AlexanderBarsc/Diplomka/Diplomka/Images/FinalAssembly.png

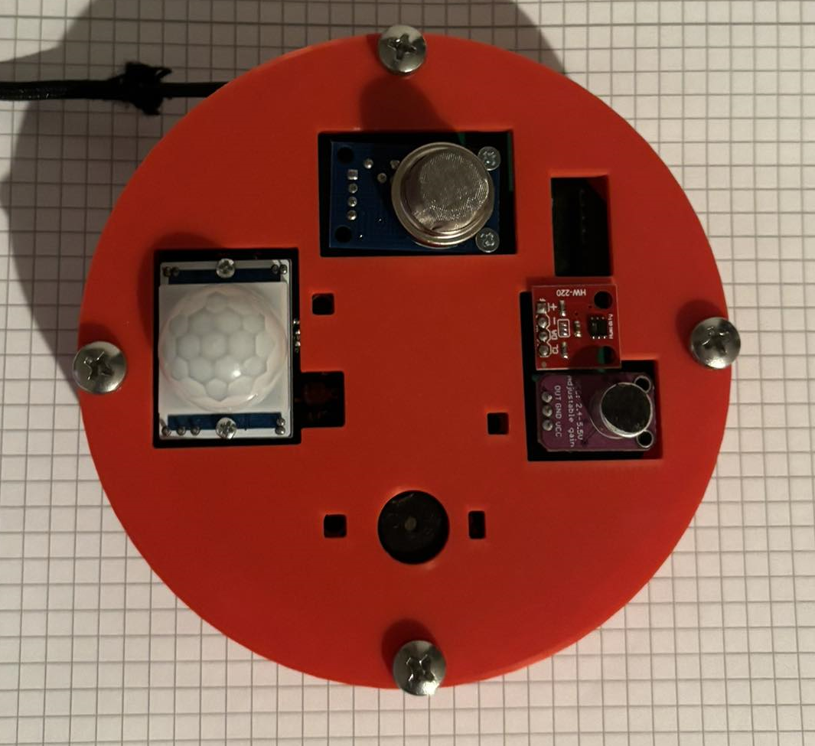
Diplomka/Images/FinalAssembly.png
