AlexanderBarsc/Diplomka/Diplomka/Images/439592605_353315911055319_5232391731507984202_n.jpg

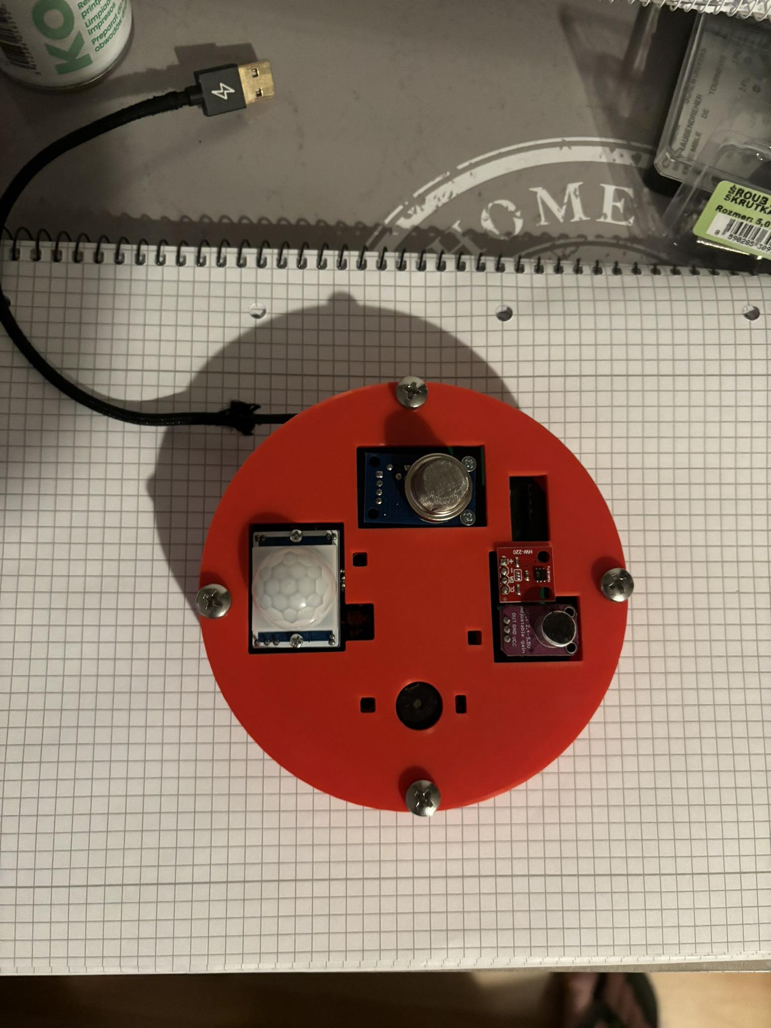
Diplomka/Images/439592605_353315911055319_5232391731507984202_n.jpg
