AlexanderBarsc/Diplomka/README.md

# Diplomka
Všechno potřebné pro diplomku
Tady odkaz na samotnou práci: https://www.overleaf.com/5378626868ssqpxgxytjcf
