AlexanderBarsc/Diplomka/Diplomka/Adafruit-MAX4466-Electret-Mic-Amplifier-PCBs-master/Adafruit-MAX4466-Electret-Mic-Amplifier-PCBs-master/MAX.png

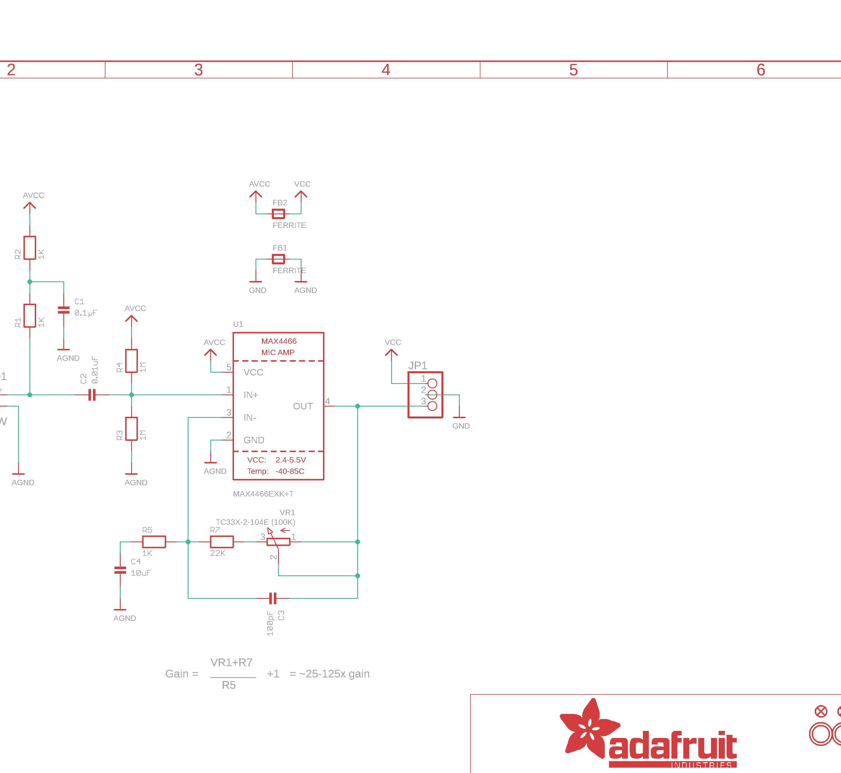
Diplomka/Adafruit-MAX4466-Electret-Mic-Amplifier-PCBs-master/Adafruit-MAX4466-Electret-Mic-Amplifier-PCBs-master/MAX.png
