AlexanderBarsc/Diplomka/Diplomka/Images/Diplomka.png

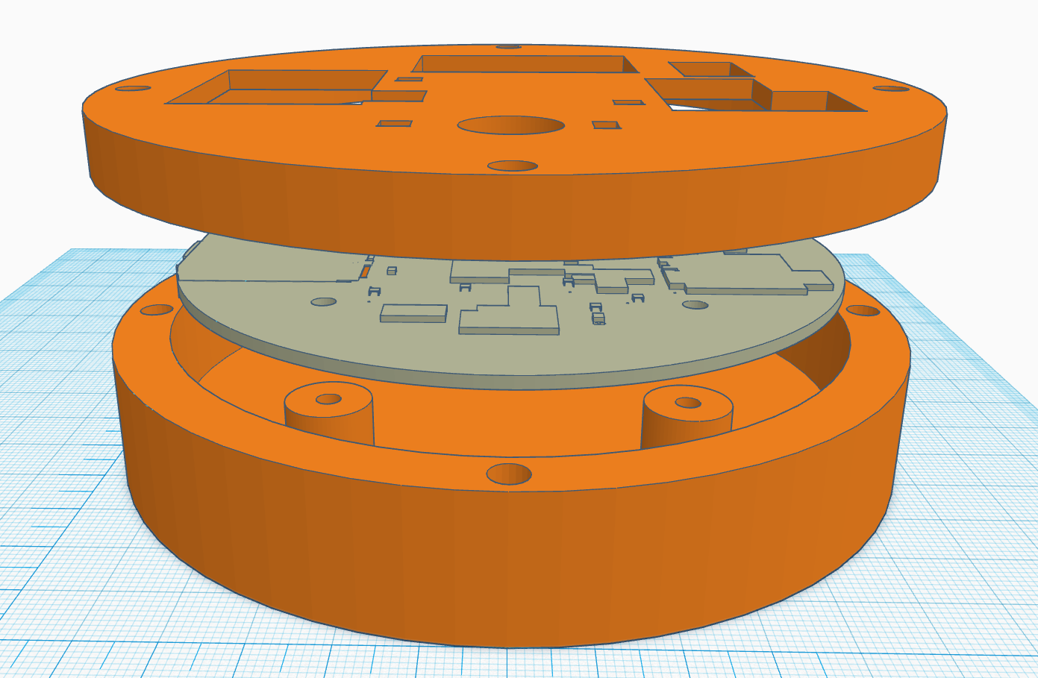
Diplomka/Images/Diplomka.png
