AlexanderBarsc/Diplomka/Diplomka/Images/DiplomkaTop.png

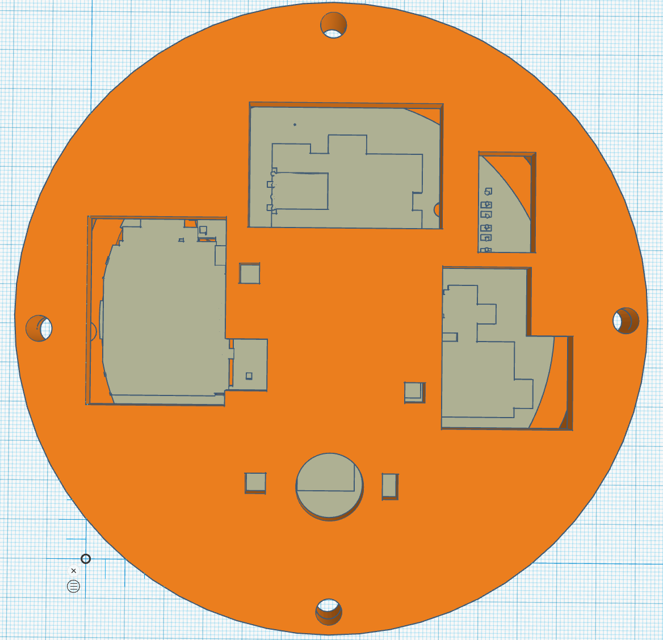
Diplomka/Images/DiplomkaTop.png
