AlexanderBarsc/Diplomka/Diplomka/Images/HC-SR501.png

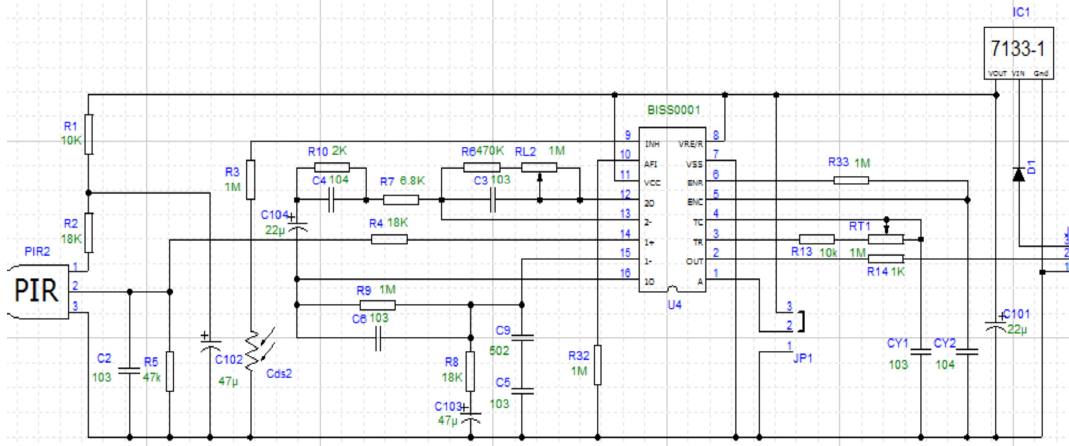
Diplomka/Images/HC-SR501.png
