AlexanderBarsc/Diplomka/Diplomka/Images/MAX.png

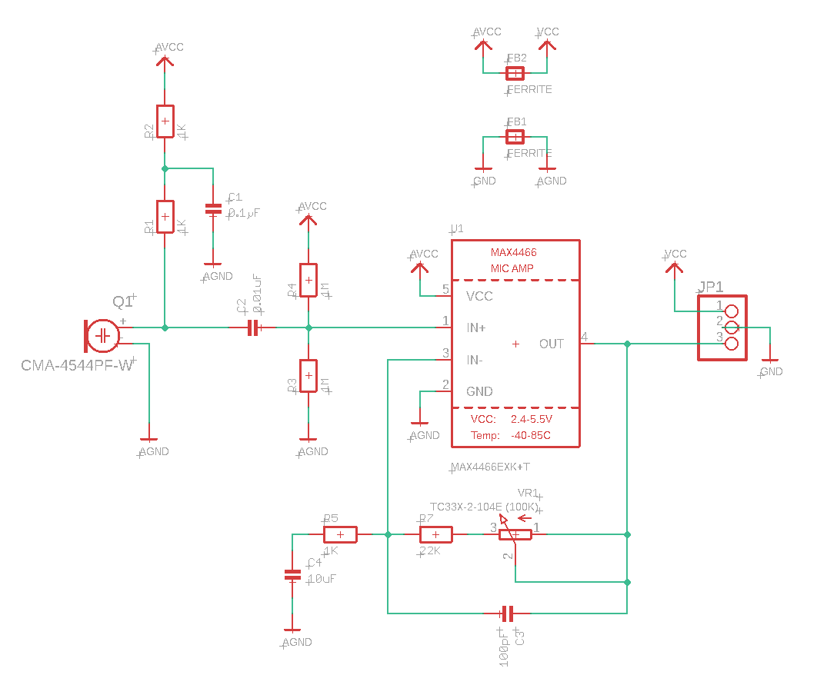
Diplomka/Images/MAX.png
