AlexanderBarsc/Diplomka/Diplomka/Images/PCBFinished.jpg

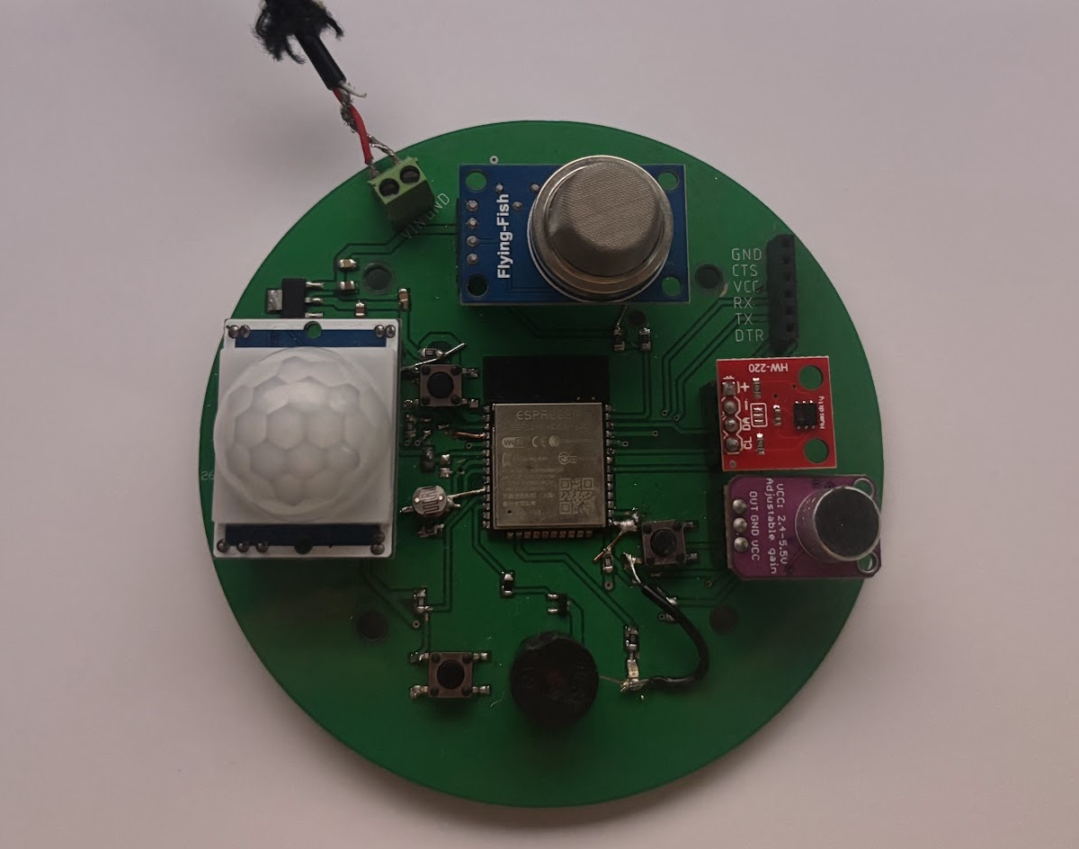
Diplomka/Images/PCBFinished.jpg
