AlexanderBarsc/Diplomka/Diplomka/Images/React.png

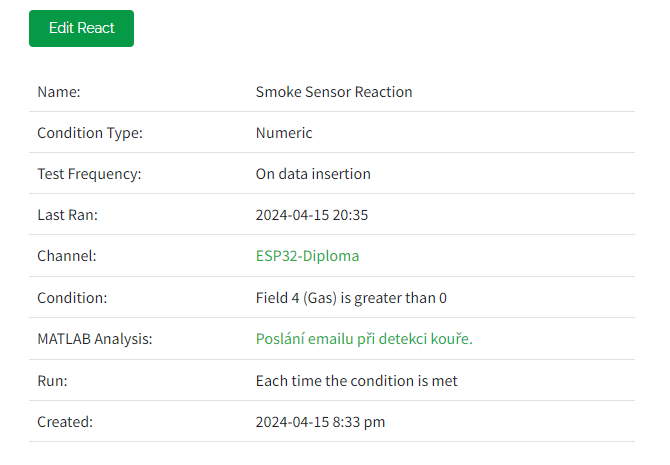
Diplomka/Images/React.png
