AlexanderBarsc/Diplomka/Diplomka/Images/Registry.png

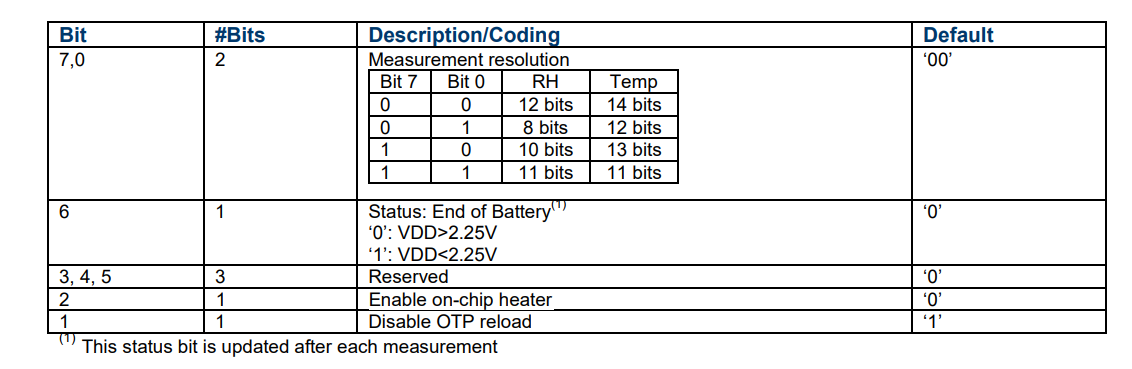
Diplomka/Images/Registry.png
