AlexanderBarsc/Diplomka/Diplomka/Images/SetThingSpeakCredentials.png

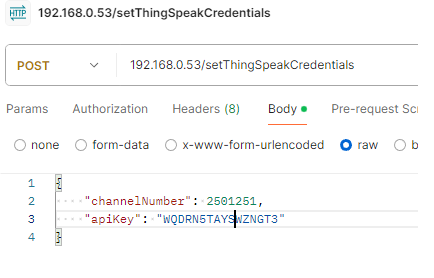
Diplomka/Images/SetThingSpeakCredentials.png
