AlexanderBarsc/Diplomka/Diplomka/Images/SmokeEmail.png

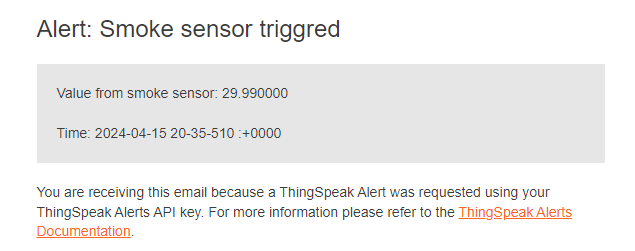
Diplomka/Images/SmokeEmail.png
