AlexanderBarsc/Diplomka/Diplomka/Images/SSID.PNG

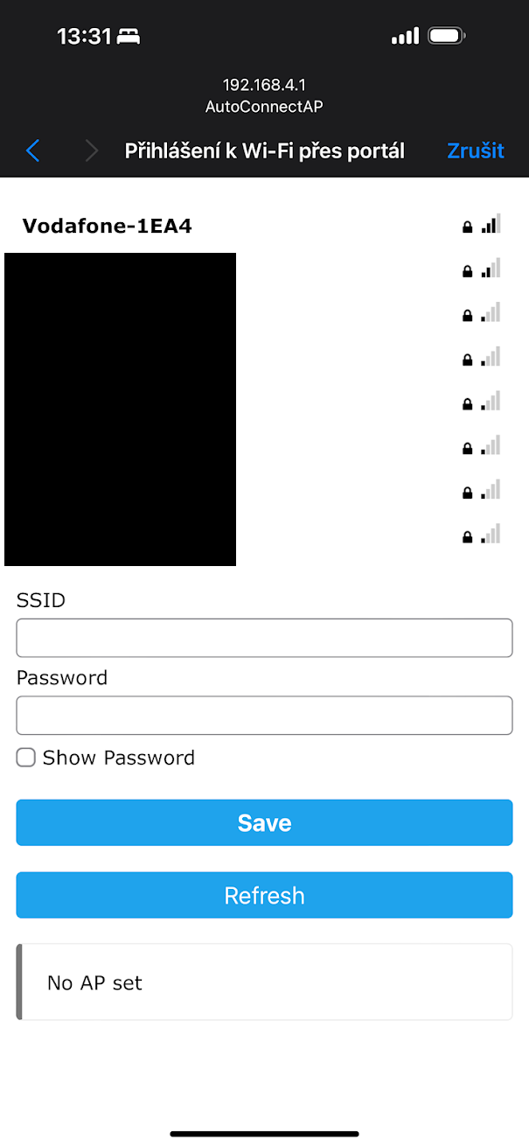
Diplomka/Images/SSID.PNG
