AlexanderBarsc/Diplomka/Diplomka/Images/VSCodePlatformIO.png

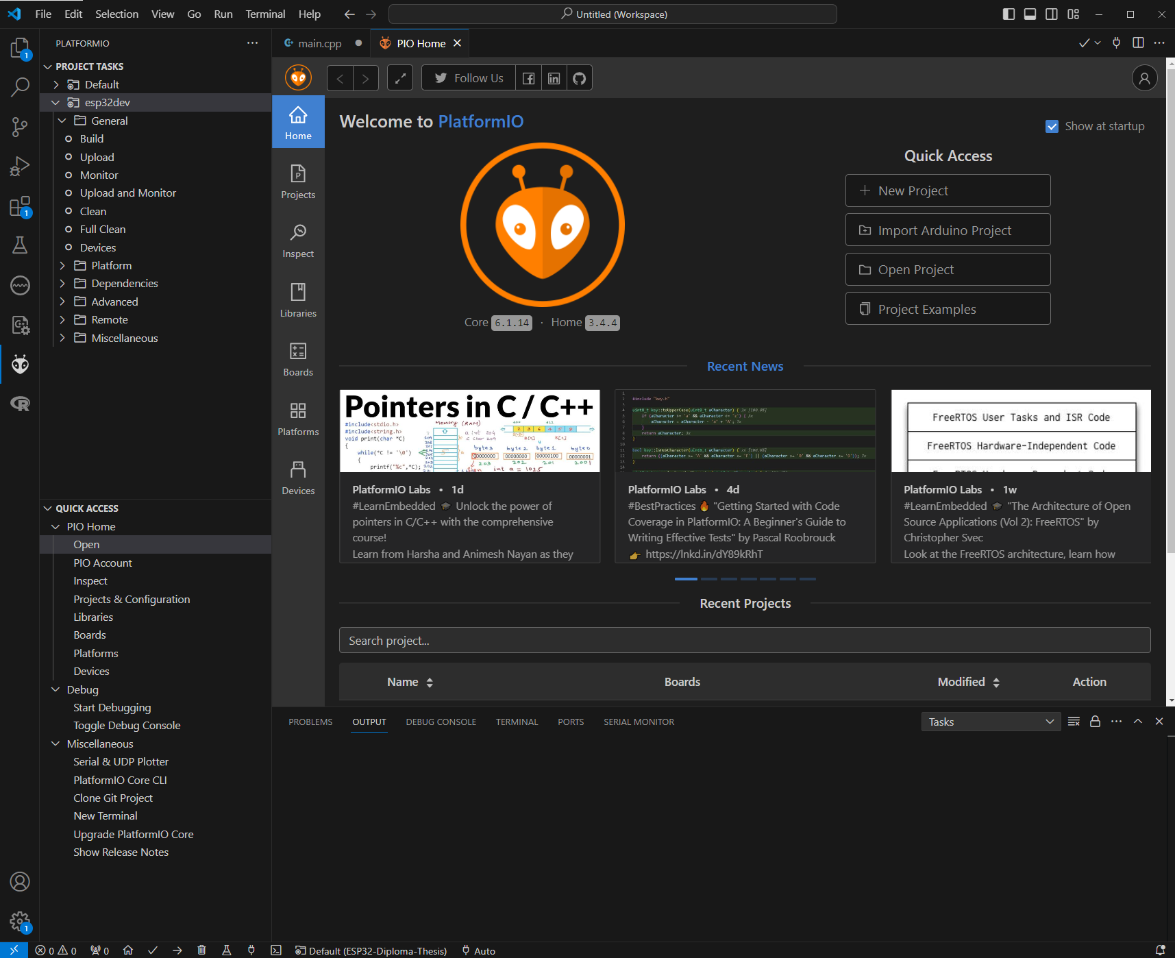
Diplomka/Images/VSCodePlatformIO.png
