AlexanderBarsc/Diplomka/UML/Diagram.drawio.png

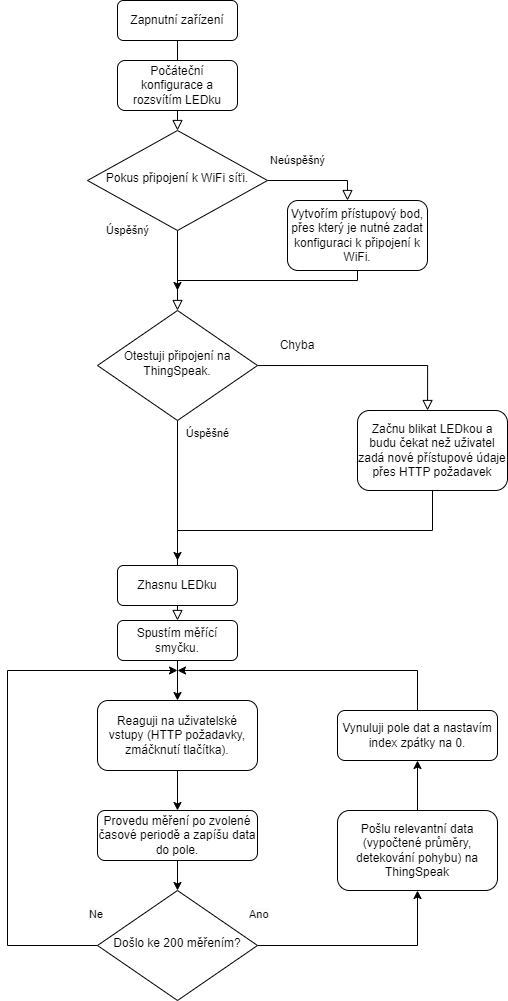
UML/Diagram.drawio.png
