AlexanderBarsc/Diplomka/UML/HTU21DDiagram.png

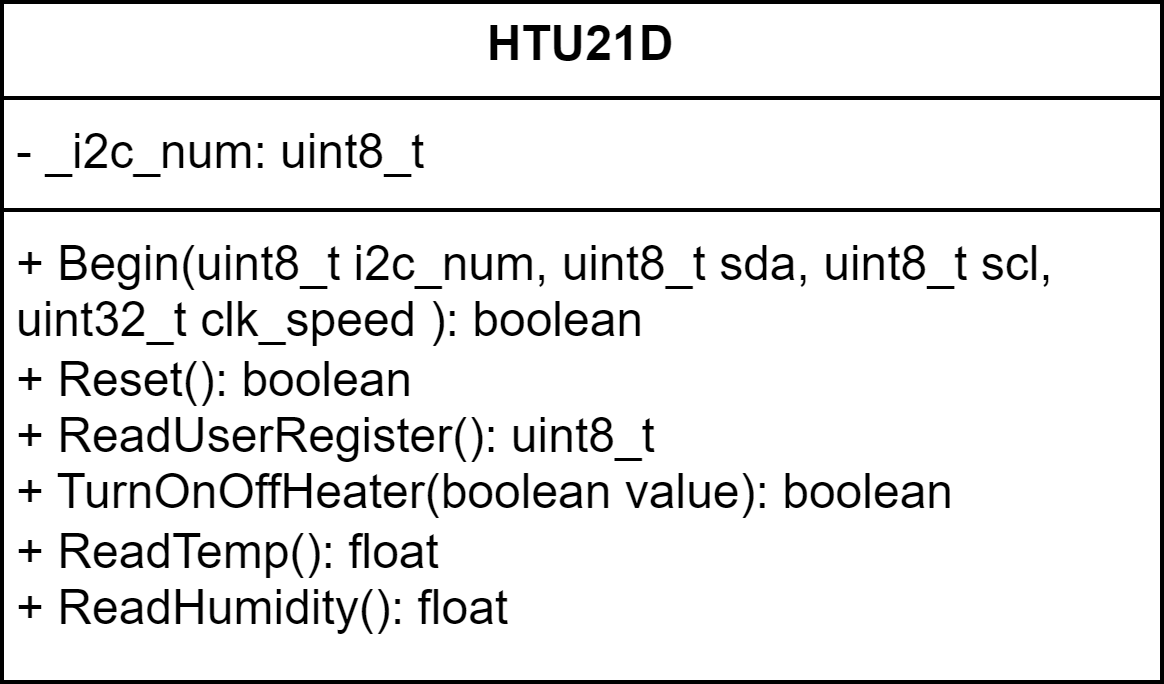
UML/HTU21DDiagram.png
