AlexanderBarsc/Diplomka/DP_BAR0469/Přílohy/Model pouzdra/Bottom.stl

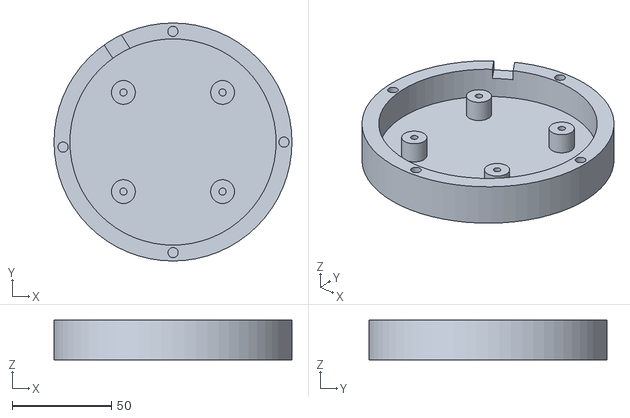
[picture p17: CAD file, 2024-03-21]
DP_BAR0469/Přílohy/Model pouzdra/Bottom.stl
120.0 x 120.0 x 20.0
