AlexanderBarsc/Diplomka/Pouzdro/Stojan.stl

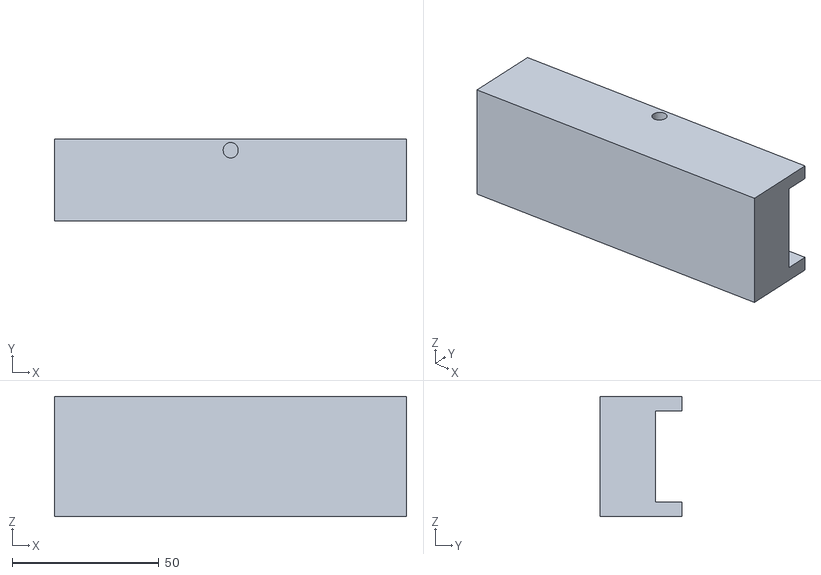
[picture p18: CAD file, 2024-06-26]
Pouzdro/Stojan.stl
120.0 x 28.0 x 41.0
