AlexanderBarsc/Diplomka/DP_BAR0469/Přílohy/Model pouzdra/Top.stl

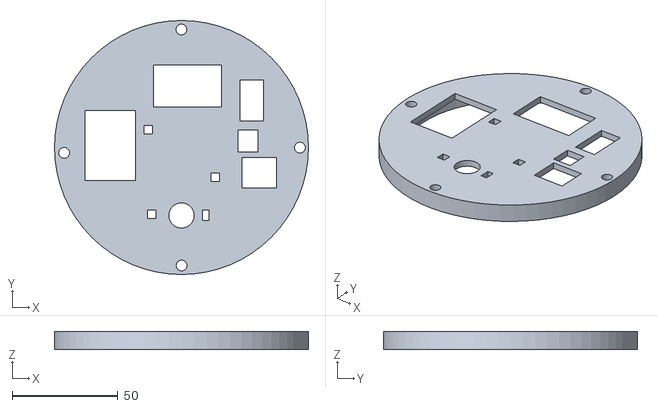
[picture p19: CAD file, 2024-03-21]
DP_BAR0469/Přílohy/Model pouzdra/Top.stl
120.0 x 120.0 x 8.60
