AlexanderBarsc/Diplomka/Obvody/StepDown.png

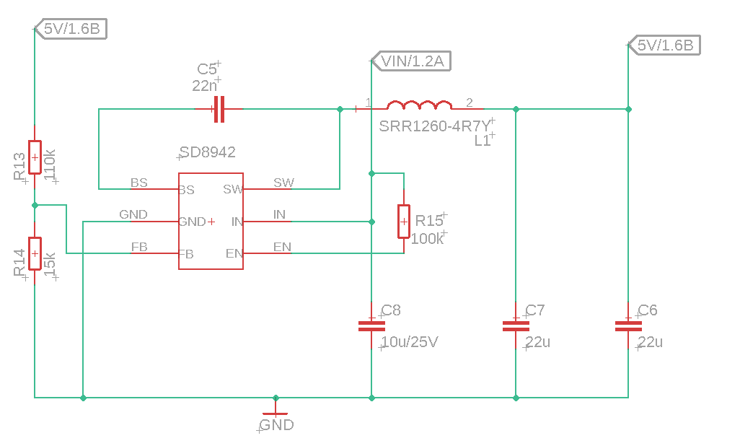
Obvody/StepDown.png
