AlexanderBarsc/Diplomka/Testování/SmokeData.csv

created_at | entry_id | field4
2024-04-29 14:37:14 UTC | 2918 | 0.00000
2024-04-29 14:37:35 UTC | 2919 | 0.00000
2024-04-29 14:37:55 UTC | 2920 | 0.00000
2024-04-29 14:38:17 UTC | 2921 | 0.00000
2024-04-29 14:38:37 UTC | 2922 | 0.00000
2024-04-29 14:38:58 UTC | 2923 | 0.00000
2024-04-29 14:39:18 UTC | 2924 | 0.00000
2024-04-29 14:39:39 UTC | 2925 | 0.00000
2024-04-29 14:39:59 UTC | 2926 | 0.00000
2024-04-29 14:40:21 UTC | 2927 | 0.00000
2024-04-29 14:40:45 UTC | 2928 | 0.00000
2024-04-29 14:41:05 UTC | 2929 | 0.00000
2024-04-29 14:41:26 UTC | 2930 | 0.00000
2024-04-29 14:41:47 UTC | 2931 | 0.00000
2024-04-29 14:42:08 UTC | 2932 | 0.00000
2024-04-29 14:42:28 UTC | 2933 | 0.00000
2024-04-29 14:42:49 UTC | 2934 | 0.00000
2024-04-29 14:43:09 UTC | 2935 | 0.00000
2024-04-29 14:43:30 UTC | 2936 | 0.00000
2024-04-29 14:43:50 UTC | 2937 | 0.00000
2024-04-29 14:44:11 UTC | 2938 | 0.00000
2024-04-29 14:44:31 UTC | 2939 | 0.00000
2024-04-29 14:44:51 UTC | 2940 | 0.00000
2024-04-29 14:45:15 UTC | 2941 | 0.00000
2024-04-29 14:45:35 UTC | 2942 | 0.00000
2024-04-29 14:45:56 UTC | 2943 | 0.00000
2024-04-29 14:46:18 UTC | 2944 | 0.00000
2024-04-29 14:46:39 UTC | 2945 | 0.00000
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
