AlexanderBarsc/Diplomka/Testování/songData.csv

created_at | entry_id | field3
2024-04-29 13:28:35 UTC | 2721 | 1830.30005
2024-04-29 13:28:56 UTC | 2722 | 1833.02502
2024-04-29 13:29:16 UTC | 2723 | 1849.23999
2024-04-29 13:29:37 UTC | 2724 | 1833.84497
2024-04-29 13:29:57 UTC | 2725 | 1831.01501
2024-04-29 13:30:18 UTC | 2726 | 1827.71497
2024-04-29 13:30:38 UTC | 2727 | 1832.70496
2024-04-29 13:30:59 UTC | 2728 | 1833.21997
2024-04-29 13:31:19 UTC | 2729 | 1827.85498
2024-04-29 13:31:40 UTC | 2730 | 1829.66003
2024-04-29 13:32:00 UTC | 2731 | 1832.56494
2024-04-29 13:32:21 UTC | 2732 | 1830.05505
2024-04-29 13:32:42 UTC | 2733 | 1829.36499
2024-04-29 13:33:02 UTC | 2734 | 1829.73999
2024-04-29 13:33:23 UTC | 2735 | 1824.68005
2024-04-29 13:33:43 UTC | 2736 | 1825.54004
2024-04-29 13:34:07 UTC | 2737 | 1826.27002
2024-04-29 13:34:27 UTC | 2738 | 1828.44995
2024-04-29 13:34:48 UTC | 2739 | 1829.45496
2024-04-29 13:35:08 UTC | 2740 | 1829.34497
2024-04-29 13:35:29 UTC | 2741 | 1829.52502
2024-04-29 13:35:49 UTC | 2742 | 1831.40503
2024-04-29 13:36:10 UTC | 2743 | 1832.81006
2024-04-29 13:36:30 UTC | 2744 | 1832.54004
2024-04-29 13:36:51 UTC | 2745 | 1832.37500
2024-04-29 13:37:11 UTC | 2746 | 1830.78503
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
