AlexanderBarsc/Diplomka/Testování/UdalostPrichod.png

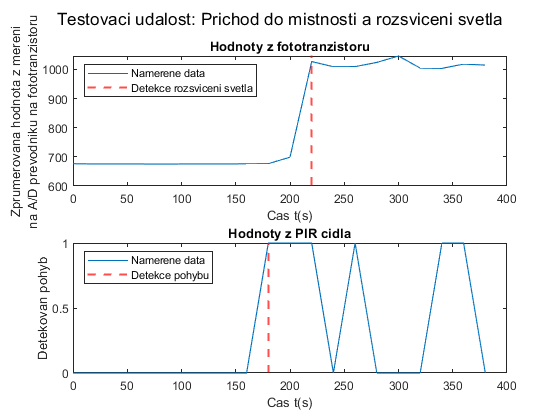
Testování/UdalostPrichod.png
