AlexanderBarsc/Diplomka/UML/MeasurementClassDiagram.png

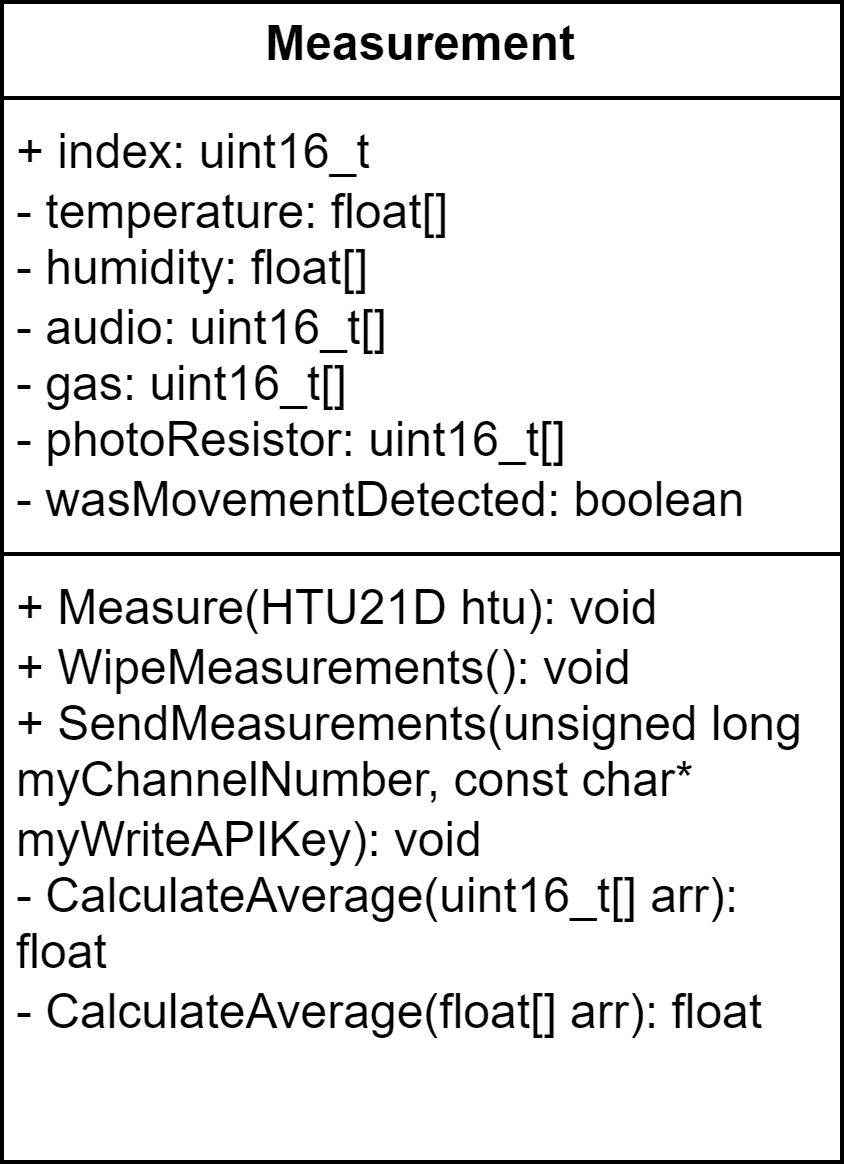
UML/MeasurementClassDiagram.png
