AlexanderBarsc/Diplomka/DP_BAR0469/Přílohy/Elektronika/DeskaCestyTop.pdf

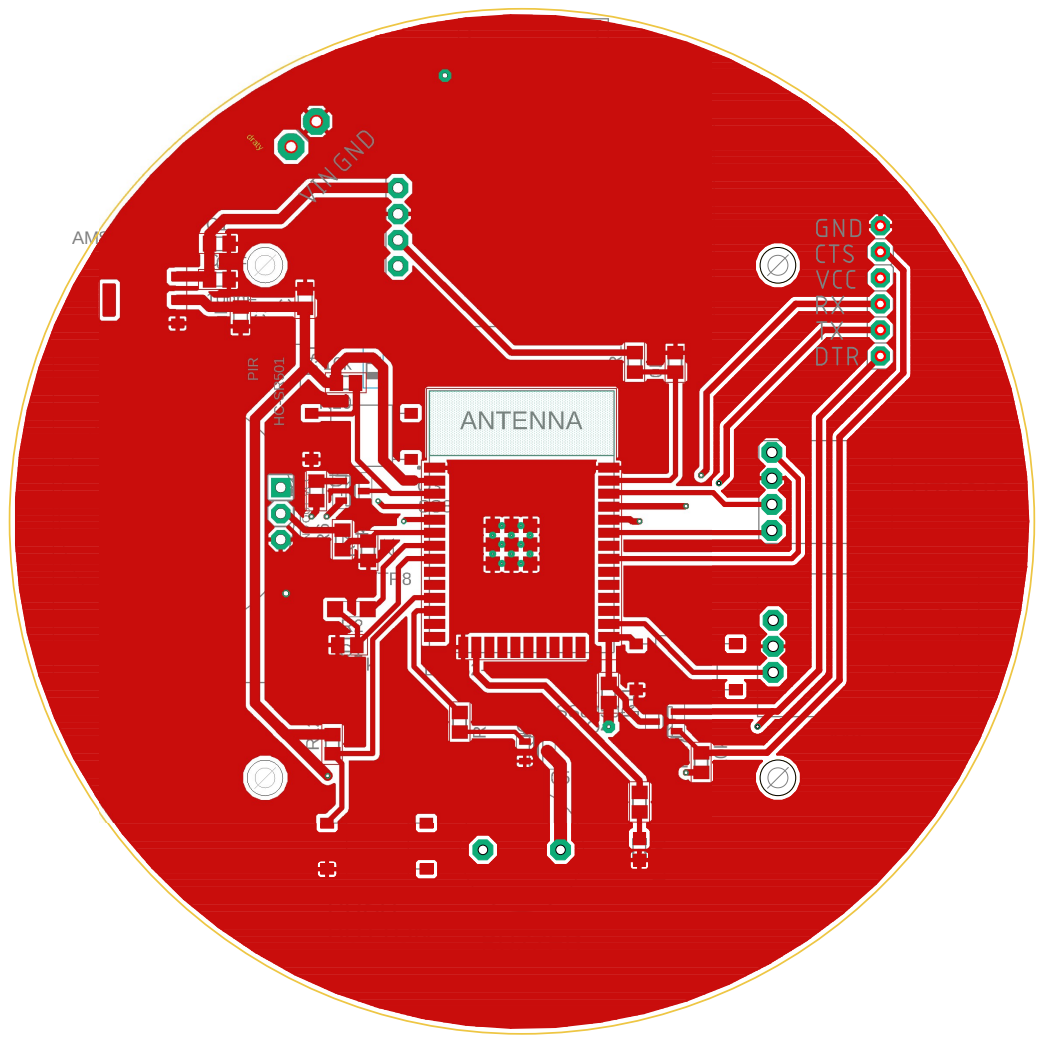
[picture p24: page 1]
LED1; MIC; HTU21D; BUZZER; PUSH BUTTON; AMS1117-3.3
