AlexanderBarsc/Diplomka/DP_BAR0469/Přílohy/Elektronika/Schéma.pdf

10uF | 10uF AMS1117-3.3

## 2 K1

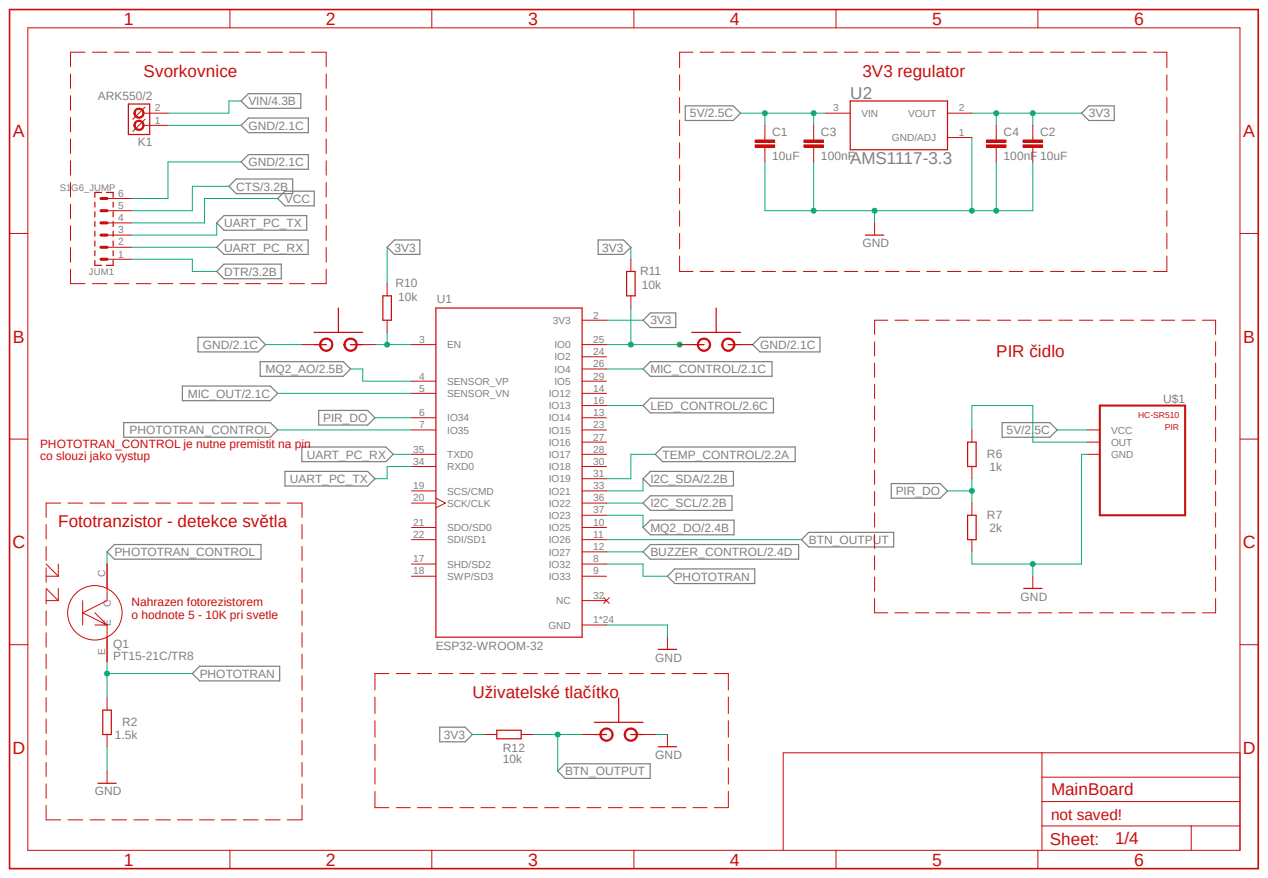
[picture p26: page 1]

PHOTOTRAN_CONTROL je nutne premistit na pin
co slouzi jako vystup

## Koliková lišta pro teplotní/ vlhkostní senzor HTU21D

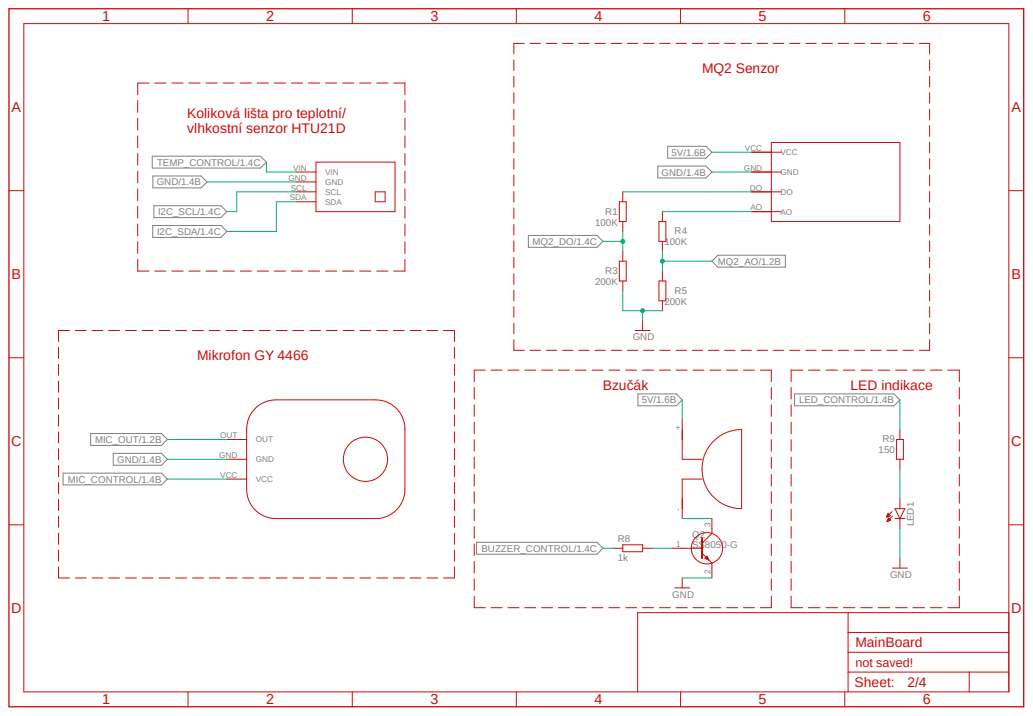
[picture p27: page 2]
GND; VCC VCC; GND GND; OUT OUT; LED¹; SDA SDA; SCL SCL; VIN VIN; GND/1.4B; BUZZER_CONTROL/1.4C; LED_CONTROL/1.4B; I2C_SCL/1.4C; I2C_SDA/1.4C; TEMP_CONTROL/1.4C; MIC_OUT/1.2B; MIC_CONTROL/1.4B; MQ2 Senzor; Mikrofon GY 4466; Bzučák; LED indikace; Sheet:; MainBoard; not saved! 2/4

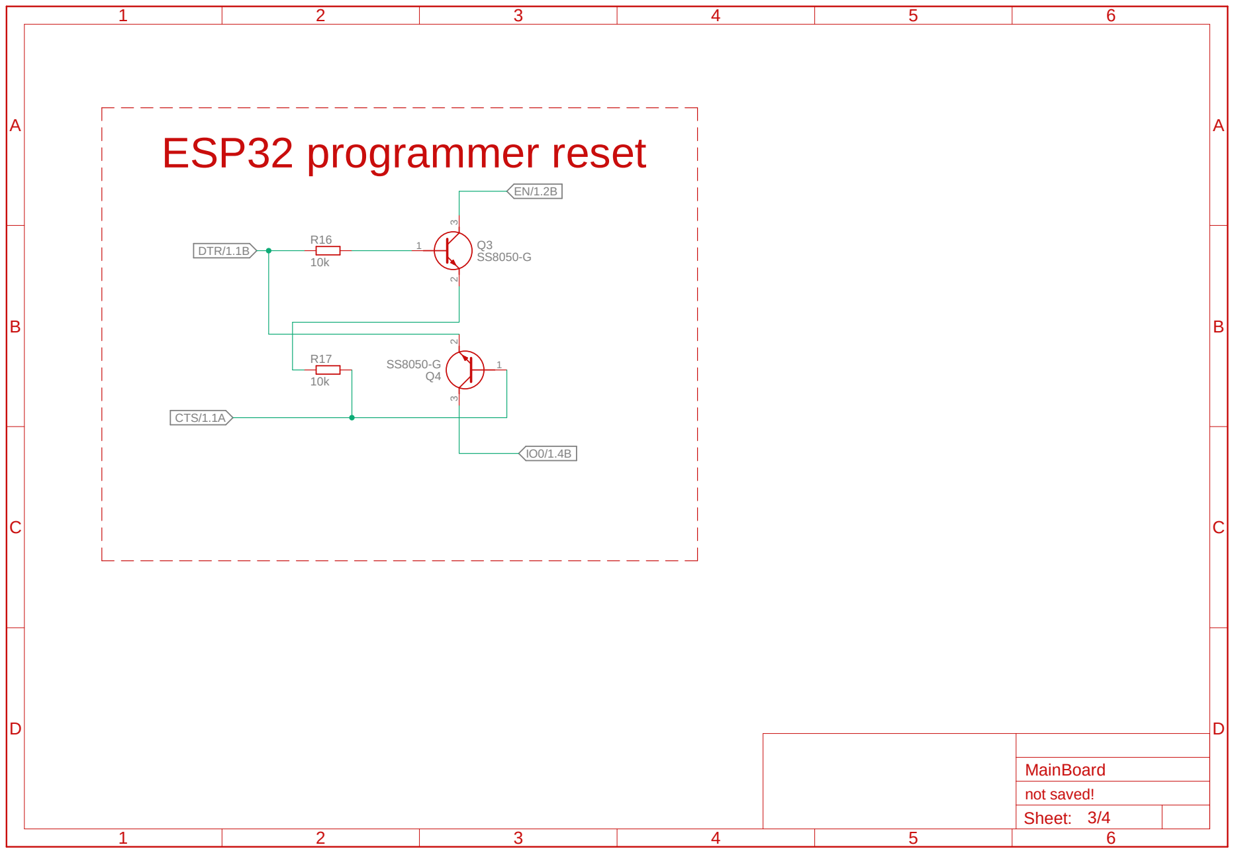
[picture p28: figure]
DTR/1.1B; CTS/1.1A; ESP32 programmer reset; Sheet:; MainBoard; not saved! 3/4

A

A

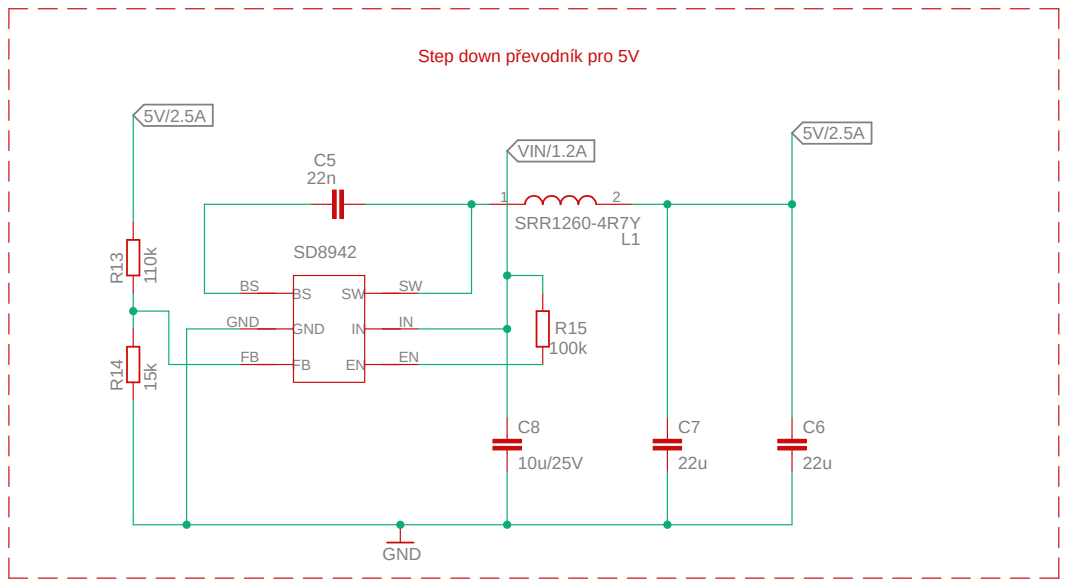
[picture p29: page 4]
22u ¹¹⁰k 15k; SRR1260-4R7Y; GND; GND GND; C6 R¹³ R¹⁴; VIN/1.2A; Sheet:; MainBoard; not saved! 4/4

Step down převodník pro 5V
