AlexanderBarsc/Diplomka/Diplomka/MainBoard.brd

## EAGLE design Diplomka/MainBoard.brd (2024-06-08)

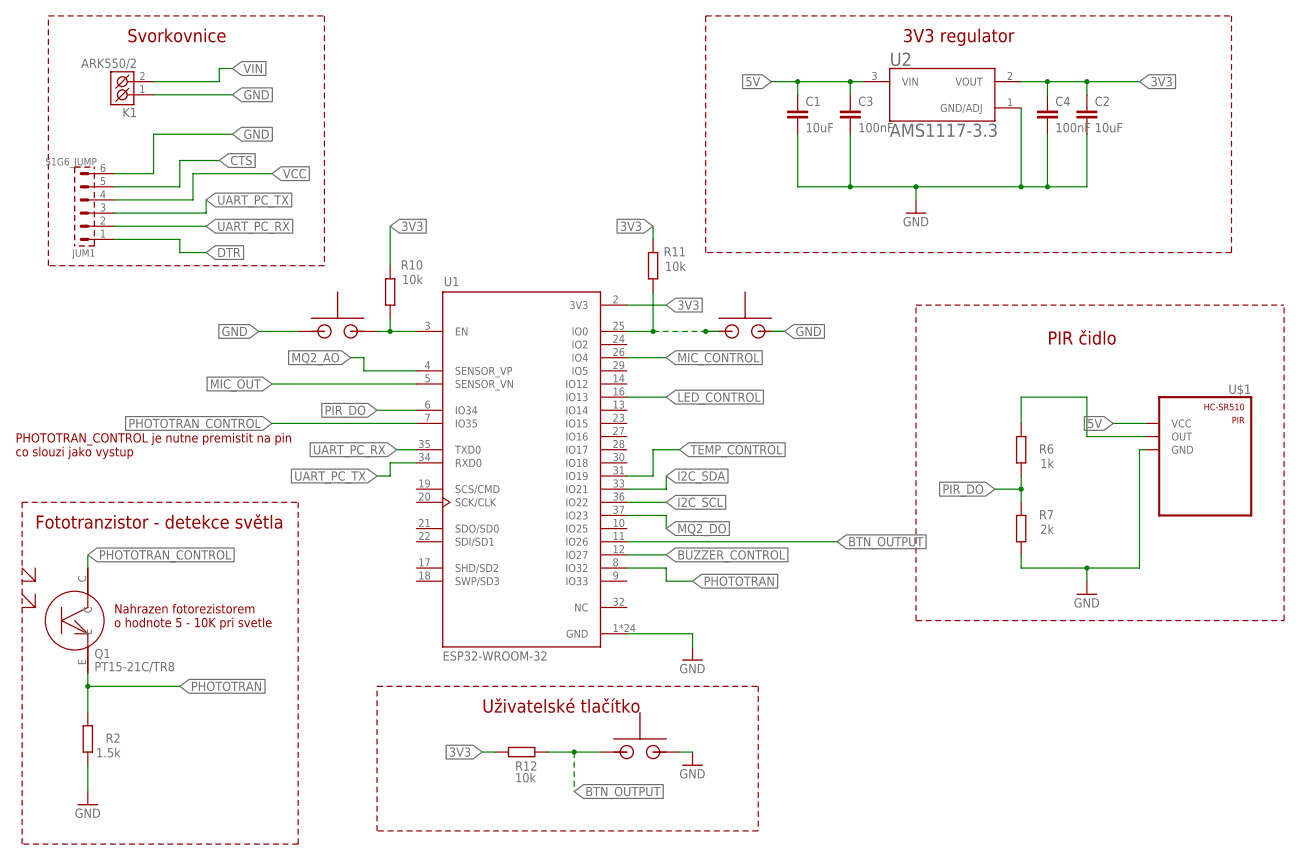
[picture p30: schematic MainBoard.sch, sheet 1]

Parts:
C1, C2: 10uF; C0805
C3, C4: 100nF; C0805
JUM1: S1G6_JUMP; S1G6_JUM
K1: ARK550/2
Q1: PT15-21C/TR8
R2: 1.5k; R0805
R6: 1k; R0805
R7: 2k; R0805
R10, R11, R12: 10k; R0805
U1: ESP32-WROOM-32; MODULE_ESP32-WROOM-32
U2: AMS1117-3.3; SOT229P700X180-4N
U$1: HC-SR501
U$6, U$7, U$8: TS6604B

Connections:
3V3: C2.1, C4.1, R10.2, R11.2, R12.2, U1.2 (3V3), U2.2 (VOUT)
5V: C1.1, C3.1, U2.3 (VIN), U$1.VCC; also elsewhere on the board
BTN_OUTPUT: R12.1, U1.11 (IO26), U$8.+
BUZZER_CONTROL: U1.12 (IO27); also elsewhere on the board
CTS: JUM1.5; also elsewhere on the board
DTR: JUM1.1; also elsewhere on the board
EN: R10.1, U1.3 (EN), U$6.+; also elsewhere on the board
GND: C1.2, C2.2, C3.2, C4.2, JUM1.6, K1.1 (K1), R2.1, R7.1, U1.1 (GND), U1.15 (GND), U1.38 (GND), U1.39_1 (GND), U1.39_2 (GND), U1.39_3 (GND), U1.39_4 (GND), U1.39_5 (GND), U1.39_6 (GND), U1.39_7 (GND), U1.39_8 (GND), U1.39_9 (GND), U1.39_10 (GND), U1.39_11 (GND), U1.39_12 (GND), U1.39_13 (GND), U1.39_14 (GND), U1.39_15 (GND), U1.39_16 (GND), U1.39_17 (GND), U1.39_18 (GND), U1.39_19 (GND), U1.39_20 (GND), U1.39_21 (GND), U2.1 (GND/ADJ), U$1.GND, U$6.-, U$7.-, U$8.-; also elsewhere on the board
I2C_SCL: U1.36 (IO22); also elsewhere on the board
I2C_SDA: U1.33 (IO21); also elsewhere on the board
IO0: R11.1, U1.25 (IO0), U$7.+; also elsewhere on the board
LED_CONTROL: U1.16 (IO13); also elsewhere on the board
MIC_CONTROL: U1.26 (IO4); also elsewhere on the board
MIC_OUT: U1.5 (SENSOR_VN); also elsewhere on the board
MQ2_AO: U1.4 (SENSOR_VP); also elsewhere on the board
MQ2_DO: U1.37 (IO23); also elsewhere on the board
unnamed: R6.2, U$1.OUT
PHOTOTRAN: Q1.E, R2.2, U1.8 (IO32)
PHOTOTRAN_CONTROL: Q1.C, U1.7 (IO35)
PIR_DO: R6.1, R7.2, U1.6 (IO34)
TEMP_CONTROL: U1.31 (IO19); also elsewhere on the board
UART_PC_RX: JUM1.2, U1.35 (TXD0)
UART_PC_TX: JUM1.3, U1.34 (RXD0)
VCC: JUM1.4
VIN: K1.2 (K2); also elsewhere on the board

Notes on the sheet:
Svorkovnice
3V3 regulator
PIR čidlo
Fototranzistor - detekce světla
Uživatelské tlačítko
Nahrazen fotorezistorem o hodnote 5 - 10K pri svetle
PHOTOTRAN_CONTROL je nutne premistit na pin co slouzi jako vystup

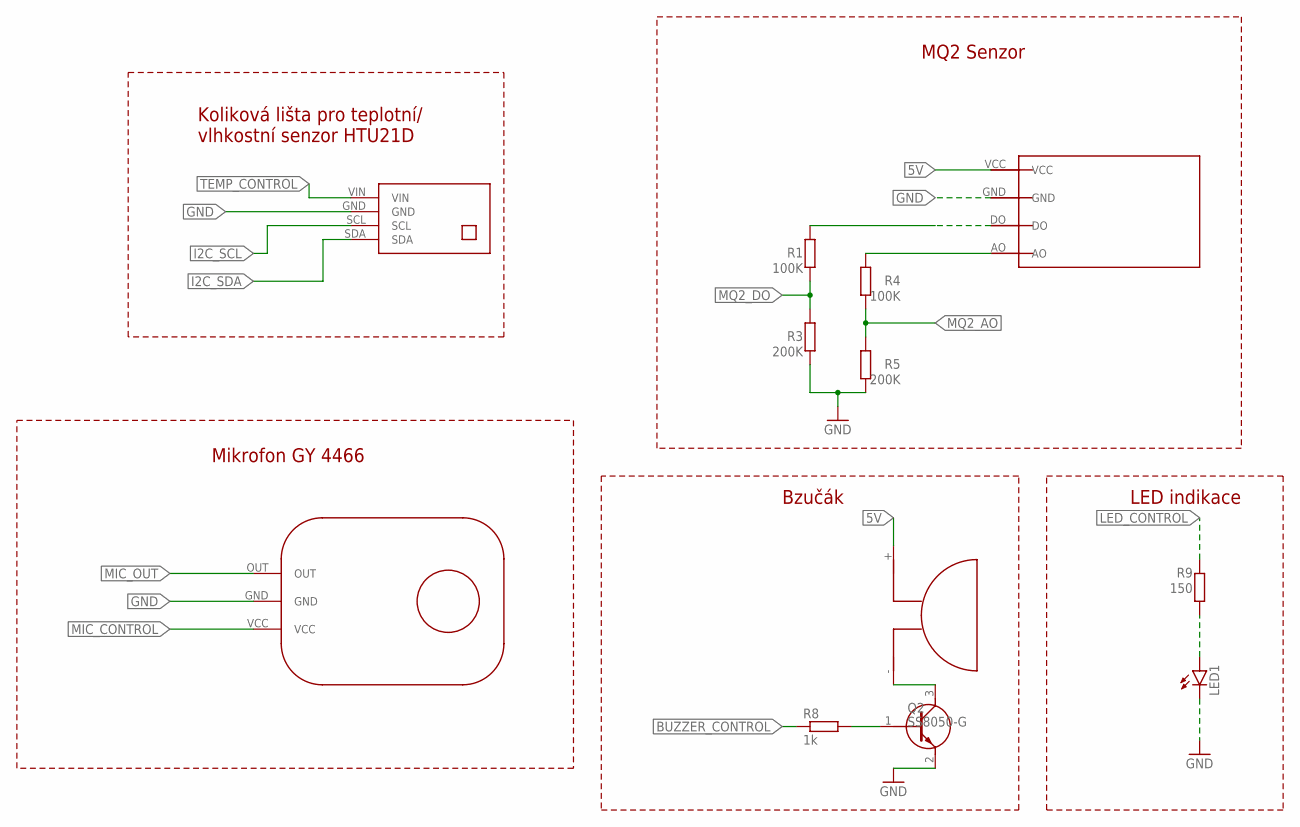
[picture p31: schematic MainBoard.sch, sheet 2]

Parts:
LED1: LEDCHIP-LED0805; CHIP-LED0805
Q2: SS8050-G; SOT95P240X115-3N
R1, R4: 100K; R0805
R3, R5: 200K; R0805
R8: 1k; R0805
R9: 150; R0805
U$2: MQ2
U$3: GY4466
U$4: BUZZER
U$5: HTU21D

Connections:
5V: U$2.VCC, U$4.+; also elsewhere on the board
BUZZER_CONTROL: R8.1; also elsewhere on the board
GND: LED1.C, Q2.2 (E), R3.1, R5.1, U$2.GND, U$3.GND, U$5.GND; also elsewhere on the board
I2C_SCL: U$5.SCL; also elsewhere on the board
I2C_SDA: U$5.SDA; also elsewhere on the board
LED_CONTROL: R9.2; also elsewhere on the board
MIC_CONTROL: U$3.VCC; also elsewhere on the board
MIC_OUT: U$3.OUT; also elsewhere on the board
MQ2_AO: R4.1, R5.2; also elsewhere on the board
MQ2_DO: R1.1, R3.2; also elsewhere on the board
unnamed: Q2.3 (C), U$4.-
unnamed: Q2.1 (B), R8.2
unnamed: R1.2, U$2.DO
unnamed: R4.2, U$2.AO
unnamed: LED1.A, R9.1
TEMP_CONTROL: U$5.VIN; also elsewhere on the board

Notes on the sheet:
Koliková lišta pro teplotní/ vlhkostní senzor HTU21D
MQ2 Senzor
Mikrofon GY 4466
Bzučák
LED indikace

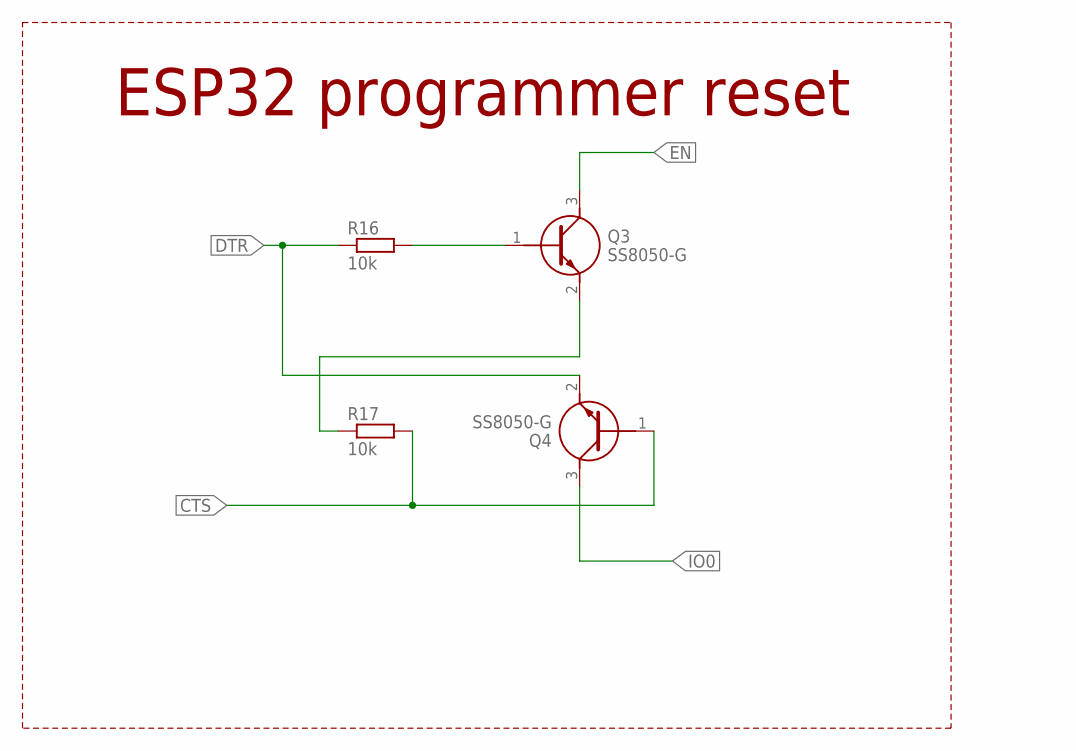
[picture p32: schematic MainBoard.sch, sheet 3]

Parts:
Q3, Q4: SS8050-G; SOT95P240X115-3N
R16, R17: 10k; R0805

Connections:
CTS: Q4.1 (B), R17.2; also elsewhere on the board
DTR: Q4.2 (E), R16.1; also elsewhere on the board
EN: Q3.3 (C); also elsewhere on the board
IO0: Q4.3 (C); also elsewhere on the board
unnamed: Q3.1 (B), R16.2
unnamed: Q3.2 (E), R17.1

Notes on the sheet:
ESP32 programmer reset

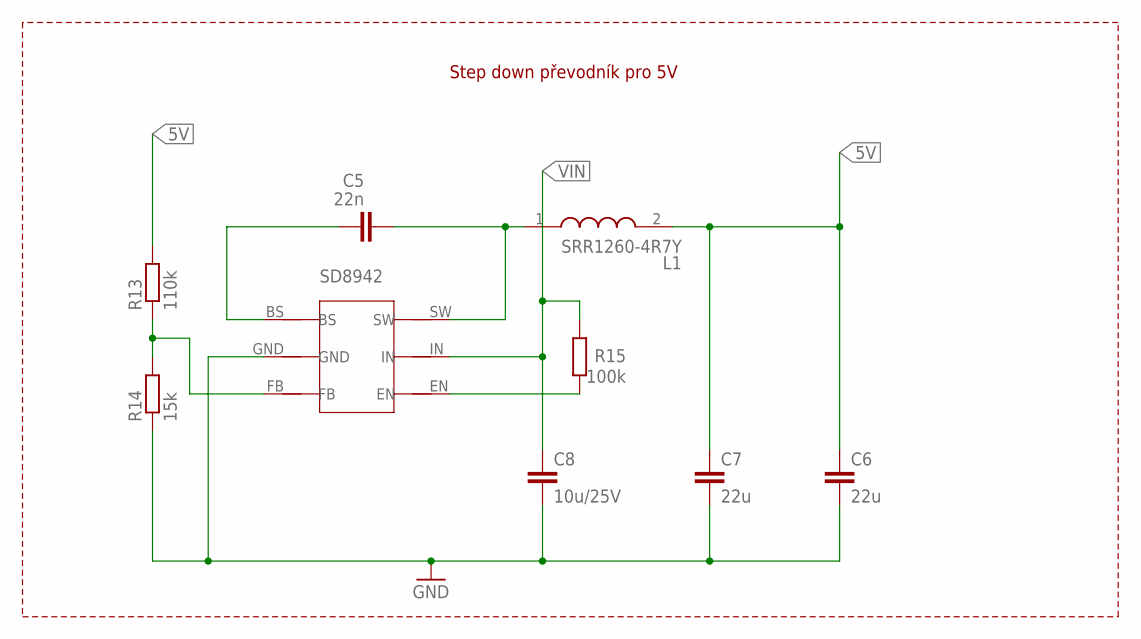
[picture p33: schematic MainBoard.sch, sheet 4]

Parts:
C5: 22n; C0805
C6, C7: 22u; C0805
C8: 10u/25V; C0805
L1: SRR1260-4R7Y; SRR12604R7Y
R13: 110k; R0805
R14: 15k; R0805
R15: 100k; R0805
U$9: SD8942

Connections:
5V: C6.1, C7.1, L1.2, R13.2; also elsewhere on the board
GND: C6.2, C7.2, C8.2, R14.1, U$9.GND; also elsewhere on the board
unnamed: C5.1, U$9.BS
unnamed: C5.2, L1.1, U$9.SW
unnamed: R15.1, U$9.EN
unnamed: R13.1, R14.2, U$9.FB
VIN: C8.1, R15.2, U$9.IN; also elsewhere on the board

Notes on the sheet:
Step down převodník pro 5V
SD8942

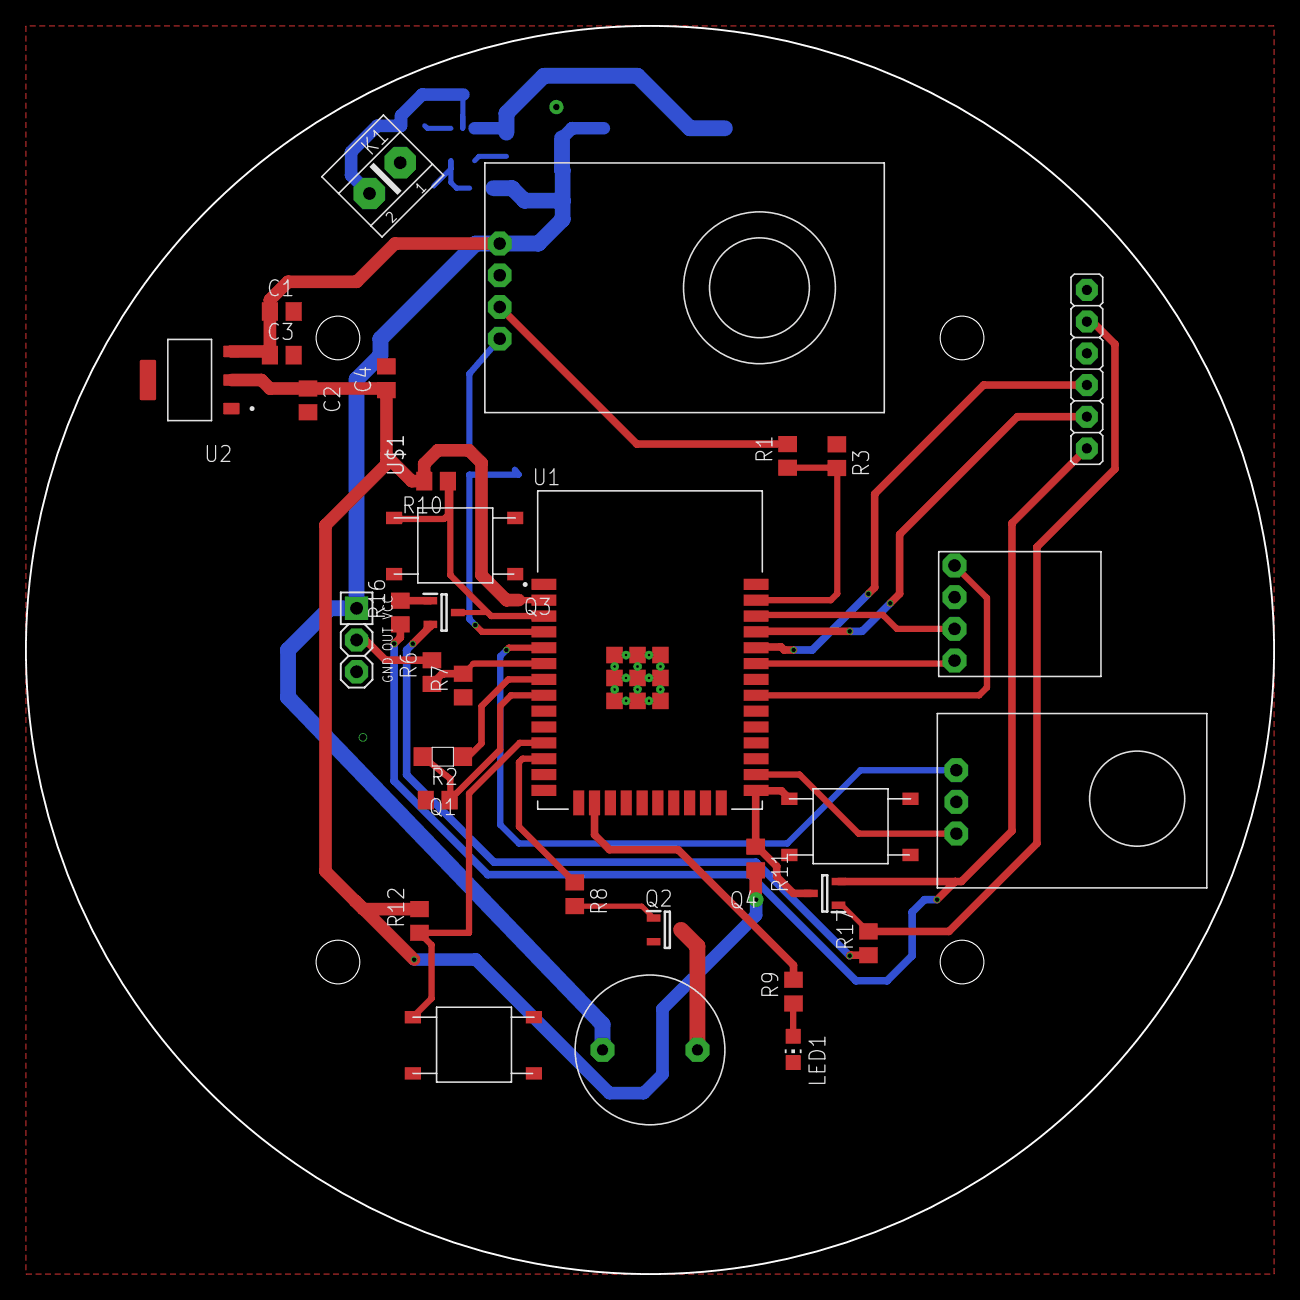
[picture p34: board MainBoard.brd from above]

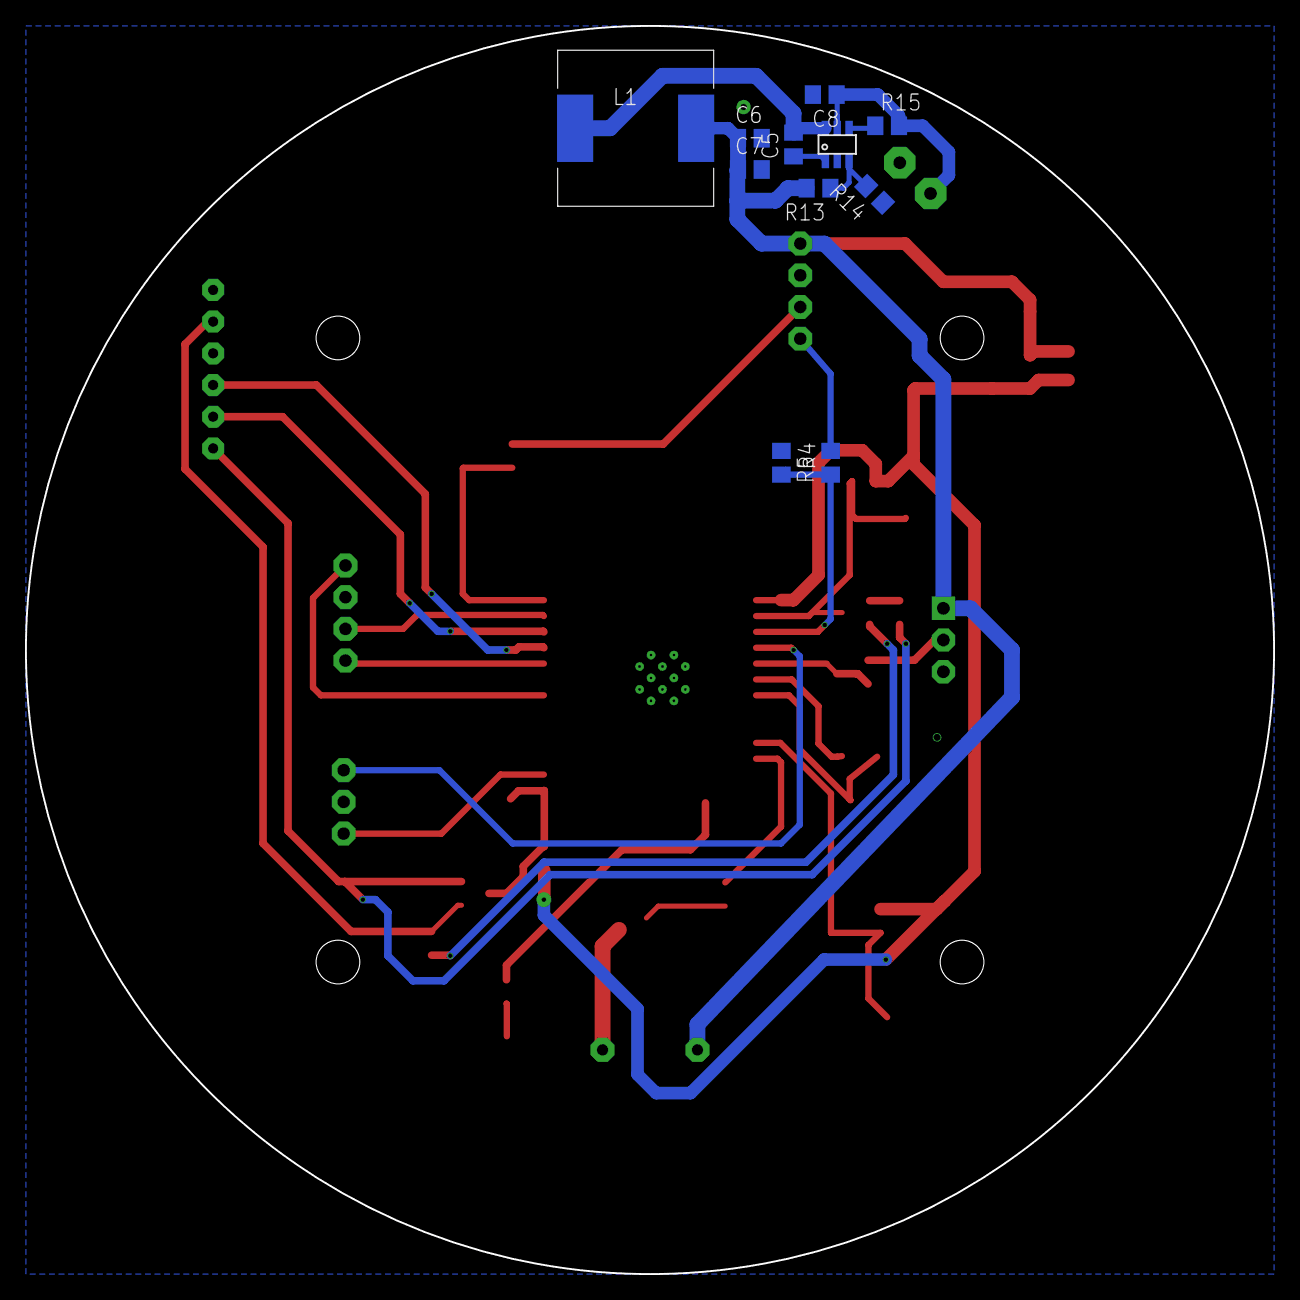
[picture p35: board MainBoard.brd from below]

Board: 2 copper layers, 100.0 x 100.0 mm, 45 parts (11 on the bottom side), 35 nets.

Other parts of the board:
U$10: A4L-LOC
