AlexanderBarsc/Diplomka/(commit log)

2023-08-20 První práce, importování ESP32 brd knihovny, začátek schématu
    [MainBoard.brd, MainBoard.sch]
2023-08-29 Added battery switch IC to schematic and library. # Please enter the commit message for your changes. Lines starting # with '#' will be ignored, and an empty message aborts the commit. # # On branch 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
    [MainBoard.brd, MainBoard.sch]
2023-09-10 Pridan regulator pro 3V3
    [MainBoard.sch, MainBoardAlt.sch]
2023-09-12 Added phototransistor
    [MainBoard.sch]
2023-09-19 Some more WIP.
    [MainBoard.sch]
2023-09-24 Hotová první verze schématu
    [Adafruit MAX4466 Mic Amp.brd, Adafruit MAX4466 Mic Amp.sch, MainBoard.brd, MainBoard.sch]
2023-09-24 Schema v1.0 hotovo
    [MainBoard.brd, MainBoard.sch]
2023-09-29 Nektere soucastky nyni budou napajene z ESP32. Pridan soubor co obsahuje kosik v GME.
    [MainBoard.brd, MainBoard.sch, kosik.csv]
2023-10-01 Zmeny v PCB
    [MainBoard.brd, MainBoard.sch]
2023-10-01 Přidány do repozitáře pravidla JLCPCB, nakresleno PCB asi z 70%ˇ.
    [MainBoard.brd, MainBoard.sch]
2023-10-14 Přidán stepdown converted. Třeba dodat vhodnou cívku a dokreslit desku.
    [MainBoard.brd, MainBoard.sch]
2023-10-15 Cca hotový plošňák, třeba udělat nějaké úpravy ale jinak dobré.
    [EDI2CAP.CFG, MainBoard.brd, MainBoard.sch, SOT95P240X115-3N.PcbLib, SRR1260-4R7Y.stp, SS8050-G.SchLib, SS8050-G.stp, chips.prt]
2023-10-18 Opravena rozteč.
    [MainBoard.brd, MainBoard.sch]
2023-10-18 Design hotový, čas importovat bitmapu.
    [MainBoard.brd, MainBoard.sch]
2023-10-18 Přidány výrobní data
    [MainBoard.brd]
2023-10-18 Přidán rozumný fototranzistor.
    [MainBoard.brd, MainBoard.sch]
2023-10-21 Udělána objednávka.
    [MainBoard.brd, MainBoard.sch, MainBoard_bottom_bom.csv, MainBoard_default_BOM_parts.csv, PnP_MainBoard_back.csv, PnP_MainBoard_front.csv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]
2024-02-26 Implementace nějakého kódu
    [MapováníPinů.xlsx]
2024-03-06 Fixed I2C
2024-03-16 Revert "WIP"
    This reverts commit 92520fda2677ff8fd32398182bd15a351072d8fc.
    [main.cpp]
2024-03-16 Pridany timer pro LEDku
2024-03-21 Přidáno pouzdro
    [Bottom.stl, Top.stl]
2024-04-08 Odstraněny přebytečné soubory
    [Adafruit MAX4466 Mic Amp.brd, Adafruit MAX4466 Mic Amp.sch, Diplomka.stl, EDI2CAP.CFG, MainBoard.brd, MainBoard.sch, MainBoard.stl, MainBoardAlt.sch]
2024-06-26 Nakreslený stojan.
    [Stojan.stl]
2024-07-03 Removed buzzer turning on when smoke is detected.
    [main.cpp]
2024-12-27 Revert "WIP in progress on FTP server."
    This reverts commit 29653f6703d1177db0453c449ee62864c4096a34.
    [main.cpp]
