AlexanderBarsc/Diplomka/(notices)

Notices in the files:
parts and their libraries:
Copyright (C) PaJa 2011-2014
